whywaita/torne-cases/stl/spacer.stl

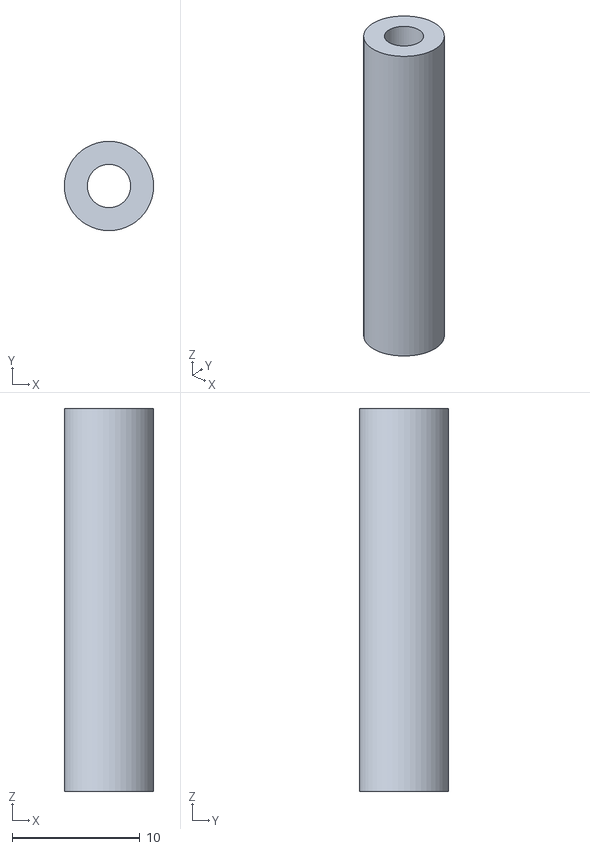
[picture p3: CAD file, 2026-10-18]
stl/spacer.stl
7.00 x 7.00 x 30.0
