whywaita/torne-cases/stl/tray.stl

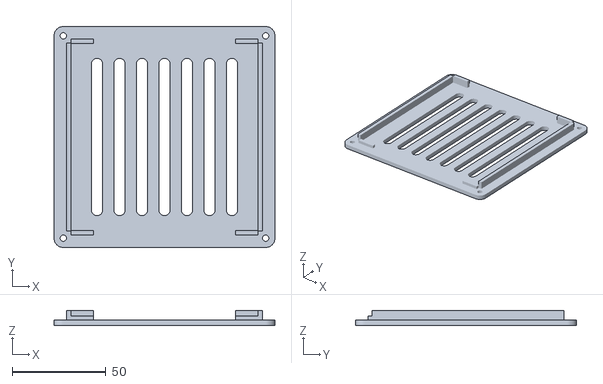
[picture p4: CAD file, 2026-10-18]
stl/tray.stl
118.0 x 118.0 x 8.00
