whywaita/torne-cases/stl/lid.stl

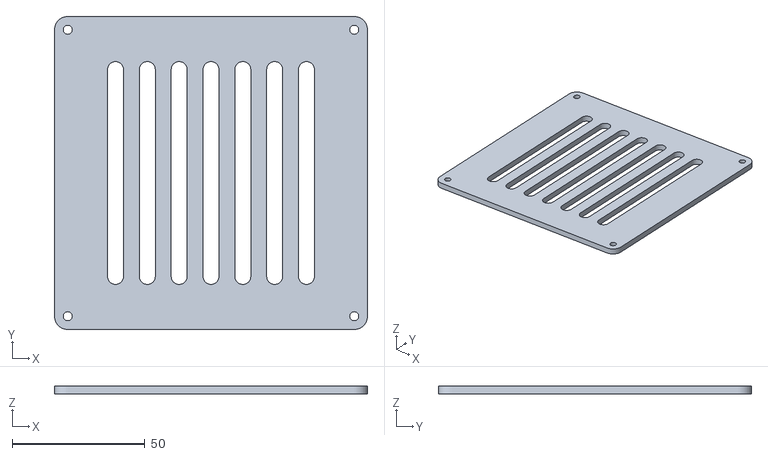
[picture p5: CAD file, 2026-10-18]
stl/lid.stl
118.0 x 118.0 x 3.00
