whywaita/torne-cases/(commit log)

2026-10-13 feat: add stackable torne rack for a1 mini
    Sony torne (CECH-ZD1J) を積み重ねて固定する Raspberry Pi クラスタケース風の
    ラックを追加する。manifold3d で STL を生成し、M3 スタンドオフで連結する。
    prompt: Banbu Lab A1 mini 向けに、Sony Torne をスタックして固定できるケースを印刷しようと思っています。Raspberry pi クラスタケースみたいなものを想定しています。固定のための棒は既存のものを使ってもよいかも。とりあえずデータの案を作ってみてください
    ----
    torne の公式寸法 (100x24x112mm) を元に、tray / lid / spacer の 3 部品を
    torne_stack.py で生成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
    [lid.stl, spacer.stl, tray.stl]
2026-10-18 fix: use measured torne size 99x99mm
    取扱説明書の 100x112mm は突起部込みで、実物の本体は 99x99mm だった。
    ガイドの内のりを 101x101mm にし、棚板を 126x126mm、穴ピッチを 114x114mm に変更する。
    prompt: これどう置く想定なの？枠線が全然torneのサイズと合ってないよ
    取扱説明書の値 (100x24x112mm) をそのまま使っていた。実寸を確認したい。
    prompt: 幅 9.9cm 奥行き9.9cm 高さは24mmでok
    TORNE_W / TORNE_D を 99mm にして STL とプレビューを再生成した。
    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
    [lid.stl, tray.stl]
2026-10-18 refactor: shrink tray to 119x119mm
    柱をガイドの外側ではなく torne の四隅のすぐ外に置き、左右ガイドは柱の手前で止める。
    穴ピッチを 109x109mm、穴から縁までを 5mm にして、棚板を 126mm 角から 119mm 角にする。
    前面の柱の間を torne が通り抜けられることと、柱とガイドが干渉しないことをテストで確認する。
    prompt: tray自体も全体的に小さくしていいのでは
    柱を四隅に寄せて棚板を 119x119mm に縮めた。
    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
    [lid.stl, tray.stl]
2026-10-18 refactor: remove guide clearance
    ガイドの内のりを実測値と同じ 99x99mm にする。
    棚板は 117x117mm、穴ピッチは 107x107mm になる。
    prompt: guideの余白、片側1mmずつも要らないね 99mmでやって
    CLEARANCE を 0 にして STL とプレビューを再生成した。
    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
    [lid.stl, tray.stl]
2026-10-18 fix: add 0.5mm guide clearance per side
    印刷で内のりが縮む分を見込み、ガイドの片側すき間を 0.5mm にする。
    内のり 100x100mm、棚板 118x118mm、穴ピッチ 108x108mm になる。
    prompt: CLEARANCE 0.5 にしておいて
    CLEARANCE を 0.5 にして STL とプレビューを再生成した。
    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
    [lid.stl, tray.stl]
2026-10-18 docs: note purchased standoffs and screws
    試用中の M3 x 30mm オス-メス スタンドオフと M3 x 5mm ねじを README に記録する。
    prompt: https://www.amazon.co.jp/dp/B078T9NN35 https://www.amazon.co.jp/dp/B0DZP3P75T この二つを買って試してるのもメモしておいて
    README の固定方法に「購入して試している部品」を追加した。
    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
2026-10-22 docs: add photo and split README into en/ja
    Add a photo of the assembled rack (cropped to remove the shipping
    label, stamp and finger; EXIF metadata stripped). README.md is now
    English and the Japanese version moves to README.ja.md.
    prompt: @~/Downloads/IMG_3026.jpg をREADMEに貼りたい / 個人情報や隠すべき情報は削除する / READMEに貼る / やって
    写真からラック部分のみを切り出し、配送ラベル・スタンプ・指を除外。EXIF を除去し 1200px に縮小して docs/photo.jpg に保存。README の preview 直下に貼付。
    prompt: README.md (英語) と README.ja.md (日本語) を用意しておいて
    README.ja.md に日本語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
2026-10-22 docs: restructure README in typical OSS style
    Reorganize README.md and README.ja.md into Features, Bill of
    materials, Assembly, Printing, Customization and Development
    sections, with the photo as a centered hero image.
    prompt: READMEの文言は著名なOSS風に書き換えておいて
    README.md と README.ja.md を OSS 定番の構成 (特徴 → 部品表 → 組み立て → 印刷設定 → カスタマイズ → 開発) に再構成。実物写真を中央に配置し、部品表を印刷部品と金物に分割、組み立てを番号付き手順化、印刷設定を表に整理。LICENSE と CI が無いため、バッジと License 節は追加していない。
    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
2026-10-22 docs: add mit license, disclaimer and m3 nuts
    Prepare the repository for going public: add an MIT LICENSE, state
    that the project is not affiliated with Sony, and list the M3 nuts
    used to fasten the lid.
    prompt: このリポジトリをpublicにしようかと思うんだけど、何か懸念がないか調査して
    秘密情報・個人情報は見つからず。LICENSE が無いこと、部品表に M3 ナットが無いこと、Sony との無関係表記が無いこと等を指摘。
    prompt: LICENSE はMITに / Sonyとは無関係のプロジェクトであることを追加 / M3 ナットも追加
    MIT の LICENSE を追加し、両 README に License 節と免責事項を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
